TheFooty/Foqi/(list of files, cad)

Other CAD files:
cad/v2_notification_grille.scad
cad/v3_nfc_holster.scad
