TheFooty/Foqi/docs/devlog.md

# Engineering Devlog

Documenting the chronological design, prototyping, and validation process of Foqi.

---

### Day 1 (Oct 11, 2026): Problem Formulation & Clearance Modeling

#### Objectives
- Establish physical boundaries for an iPhone 13 inside a typical protective bumper case.
- Determine minimum structural wall thickness for FDM printing.

#### Observations & Anthropometric Sizing
- Bare iPhone 13 dimensions: 146.7 mm x 71.5 mm x 7.65 mm.
- Standard protective case (TPU/polycarbonate hybrid) increases dimensions to ~152 mm x 78 mm x 13 mm.
- Set internal clearance targets:
  - Width: 82.0 mm (+4.0 mm clearance)
  - Depth: 16.0 mm (+3.0 mm clearance)
  - Height: 155.0 mm (+3.0 mm clearance)
- Wall thickness set to 3.0 mm to resist flex when dropped or torqued.
- Implemented `rounded_box` module using 2D extrusion of 4 circles within a `hull()` to avoid OpenSCAD's computationally expensive `minkowski()` sum.

---

### Day 2 (Oct 13, 2026): Anti-Touch Grille & Anthropometric Sizing

#### Objectives
- Create a front viewing face that keeps notifications legible while blocking screen interaction.
- Integrate pass-through charging access.

#### Research & Calculations
- Capacitive touchscreen activation requires approximately 8–10 mm of conductive fleshy fingertip contact.
- Adult index finger breadth averages 16–20 mm (5th percentile is ~14 mm).
- Designing slots at 5.5 mm with 4.9 mm rigid bars makes screen interaction physically impossible:
  - Total span across front face: 68 mm
  - 7 slots of 5.5 mm width spaced across the display
  - Rounded capsule ends (`pill_slot_y`) eliminate sharp internal stress concentrations and ensure clean FDM bridgeability.
- Added a 20 mm x 8 mm slotted oval port at the bottom floor for Lightning and USB-C cable pass-through.

---

### Day 3 (Oct 16, 2026): Integrated NFC Holster & Center-of-Gravity Stabilization

#### Objectives
- House a standard credit-card sized NFC card (CR80: 85.6 mm x 54.0 mm x 1.0 mm).
- Position card to immediately trigger automation apps (Foqos) via iPhone tap.
- Address desk stability: a 158 mm tall enclosure with a 22 mm base footprint is prone to tipping.

#### Mechanical & RF Engineering Choices
- **NFC Coil Alignment**: On the iPhone 13, the internal NFC loop antenna is situated in the upper 25 mm of the chassis near the camera bump.
- **Side Holster Placement**: Housing the card vertically along the upper side wall places the card's antenna within 3.0 mm of the iPhone's coil.
- **Friction-Fit Clearance**:
  - Width: 54.0 mm + 0.8 mm clearance = 54.8 mm
  - Thickness: 1.0 mm + 0.6 mm clearance = 1.6 mm
- **Thumb Ejection Mechanism**: An 18 mm circular cutout paired with a vertical slide channel allows the card to be ejected with a single upward thumb swipe.
- **Outrigger Base Geometry**: Instead of floating the holster mid-air (which would require messy 3D printing supports), extending the holster down to Z=0 expands the desk footprint from 22 mm to 60.8 mm deep, solving center-of-gravity tipping issues while keeping prints 100% support-free.

---

### Day 4 (Oct 19, 2026): Modular Locking System & Print-Plate Optimization

#### Objectives
- Provide a physical lockout mechanism to prevent spontaneous removal of the phone.
- Engineer sliding interlocks capable of withstanding physical prying.
- Optimize component disposition for 1-click FDM batch printing.

#### Kinematics & Mechanical Interlocks
- **Sliding Lid Tracks**: Implemented horizontal T-slot / rail grooves inside the upper rim:
  - Rail depth: 2.0 mm
  - Rail height: 3.5 mm
  - FDM printer clearance tolerance: 0.4 mm per side to ensure smooth gliding without binding or loose play.
- **Padlock Hasp Alignment**:
  - 6.5 mm shackle hole accommodates standard luggage, gym, or time-lock padlocks (Master Lock 140D standard shackle is ~6.0 mm).
  - Front flange integrates a 45-degree under-chamfer, making it self-supporting during vertical printing.
- **Print Disposition**:
  - `part_to_render = "print_plate"` positions the Cage upright and inverts the Lid 180 degrees onto its flat top face.
  - Zero support material required on any surface.

---

### Day 5 (Oct 22, 2026): Physical Prototype Testing & DFAM Failure Analysis

#### Observations & Failure Mode Diagnosis
- Initial test print on a Bambu Lab A1 exhibited stringing/spaghetti extrusion near the top of the viewing grille ($Z \approx 135\text{ mm}$).
- **Root Cause Analysis (Bed-Slinger Harmonic Oscillation)**: The Bambu Lab A1 bed-slinger translates the print bed along the $Y$-axis at high accelerations. The 123 mm tall, slender 3.0 mm vertical grille pillars had an aspect ratio $>40:1$, causing resonance vibration at high $Z$.
- **Bridging Collapse**: When capping the 7 wobbly pillars simultaneously, nozzle contact deflection caused bridge failure and mid-air spaghetti extrusion.
- **Clearance Feedback**: User testing revealed standard 16.0 mm cavity depth was overly snug for thick ruggedized protective phone cases.

#### Engineering Countermeasures
1. **Cavity Expansion**: Expanded internal compartment depth from 16.0 mm to **20.0 mm** and width from 82.0 mm to **85.0 mm**, accommodating thick bumper cases, wallet folios, and pop-sockets.
2. **Dual-Bank Grille with Center Tie-Rib**: Introduced an 8.0 mm solid horizontal mid-rib dividing the grille into two 57.5 mm banks. This cuts unsupported column length in half, multiplying bending stiffness by $8\times$ ($2^3$) and eliminating bed oscillation.
3. **Cathedral Arch Tops**: Redesigned slot ceilings with self-supporting 45-degree pointed arches (`pointed_slot_y`), eliminating horizontal bridging over mid-air.
4. **Self-Supporting Tab Gusset**: Integrated a continuous 45-degree ramp beneath the front padlock hasp, removing all mid-air cantilevers for 100% support-free printing.
5. **Padlock Tab Perimeter Reinforcement**: Root cause analysis of lid tab fracture revealed the 6.5 mm shackle hole breached the outer perimeter by 1.75 mm, producing an open notch with a sub-millimeter tip. Expanded tab depth to 13.0 mm and height to 22.0 mm, guaranteeing 3.25 mm solid plastic perimeters on front/back walls and a robust 9.75 mm solid bottom tip.
6. **Closure Mechanism Kinematic Redesign (Drop-In Security Cap)**: Physical assembly evaluation revealed that horizontal sliding tracks were kinematically overconstrained by the fully enclosed perimeter walls. Redesigned closure into a precision Drop-In Cap featuring a 10 mm internal retention core and overlapping forward padlock eyelet tabs. The 10 mm core locks all planar translations ($X$ and $Y$), while the concentric vertical 6.5 mm shackle holes firmly constrain vertical lift ($Z$) when locked.

---

### Day 6 (Oct 24, 2026): Hardware-Free Closure & Dual-Action Locking Pin

#### Objectives
- Provide a completely 3D-printable, zero-hardware closure solution for the overlapping 6.5 mm eyelet tabs.
- Enable quick push-to-lock retention for everyday focus sessions without requiring a metal padlock.
- Maintain optional secondary tamper-resistant deadlocking.

#### Kinematics & Mechanical Geometry
- **Pin Shaft Clearance**: Sized at $\varnothing 5.9\text{ mm}$ for smooth clearance fit inside the $\varnothing 6.5\text{ mm}$ eyelets (total diametral clearance $0.6\text{ mm}$, preventing binding from layer seam artifacts).
- **Tab Stack Sizing**: Sized to traverse the $17.5\text{ mm}$ effective tab stack ($8.0\text{ mm}$ cage tab + $6.0\text{ mm}$ centerline support ramp + $3.5\text{ mm}$ lid tab) with $1.0\text{ mm}$ axial relief before the retention detent lands ($18.5\text{ mm}$ total grip length).
- **Bug Fix (Blind Eyelet Hole Remediation)**: Inspection of the cage underside revealed the eyelet hole was previously blind at the bottom. The initial boolean cylinder subtraction only spanned `cage_tab_t` ($8.0\text{ mm}$), leaving $\approx 6.0\text{ mm}$ of solid material from the $45^\circ$ support ramp uncut. Expanded cylinder subtraction to `cage_tab_t + hasp_ramp_h + 2 * eps` ($20.1\text{ mm}$), punching completely through the ramp to create an uninterrupted vertical through-hole.
- **Bifurcated Cantilever Snap Detent**:
  - $1.2\text{ mm}$ central flex slot ($12.0\text{ mm}$ length) with $\varnothing 1.6\text{ mm}$ circular relief fillet at the root to dissipate notch stress.
  - $45^\circ$ lead-in entry cone ($\varnothing 4.1\text{ mm}$ tip to $\varnothing 6.9\text{ mm}$ waist) for effortless press-fit entry.
  - $26.5^\circ$ reverse camming ramp allowing intentional pull-to-release under deliberate finger force while preventing accidental dislodgement.
- **Deadlock Cross-Pin Hole**: A transverse $\varnothing 2.2\text{ mm}$ cotter hole passes through the prongs beneath the cage tab. Inserting a cotter wire, paperclip, or wire tag physically prevents prong compression, deadlocking the pin against removal.
- **Ergonomic Flanged Knob**: $\varnothing 14.0\text{ mm}$ head with scalloped perimeter grip flutes and a transverse $\varnothing 3.2\text{ mm}$ lanyard loop for tether cords or pull ribbons.
- **DFAM & Print Orientation**: Prints upright with the flat head on the print bed. Zero support material required.
