TheFooty/Foqi/(commit log)

2026-10-11 initial commit: project problem statement and v1 clearance geometry
    [v1_clearance_box.scad]
2026-10-13 feat(cad): add 3d-printable dual-action locking pin for hardware-free closure
    [locking_pin.scad]
2026-10-13 fix(cad): extend padlock cylinder through 45-deg support ramp to eliminate blind hole
    [foqi.scad, locking_pin.scad]
2026-10-13 feat(cad): implement anti-touch notification grille and charger pass-through
    [v2_notification_grille.scad]
2026-10-16 feat(cad): integrate CR80 NFC card holster and desk outrigger base
    [v3_nfc_holster.scad]
2026-10-19 feat(cad): add modular sliding lid with padlock hasp and multi-part print plate
    [foqi.scad]
2026-10-22 fix(cad): fuse locking lid hasp tongue into main plate to eliminate floating mesh artifact
    [foqi.scad]
2026-10-23 feat(cad): expand phone cavity to 20mm and add anti-vibration grille cross-rib
    [foqi.scad]
2026-10-23 fix(cad): reinforce padlock tab to 13mm depth with 9.75mm solid tip to prevent fracture
    [foqi.scad]
2026-10-23 feat(cad): redesign closure to drop-in security cap with vertical padlock eyelet tabs
    [foqi.scad]
